squidgeefish/AxxSolder/AxxSolder_hardware/3rd-parties-libraries/3D-models/GMT020-02 Ver1.1 LCD.step

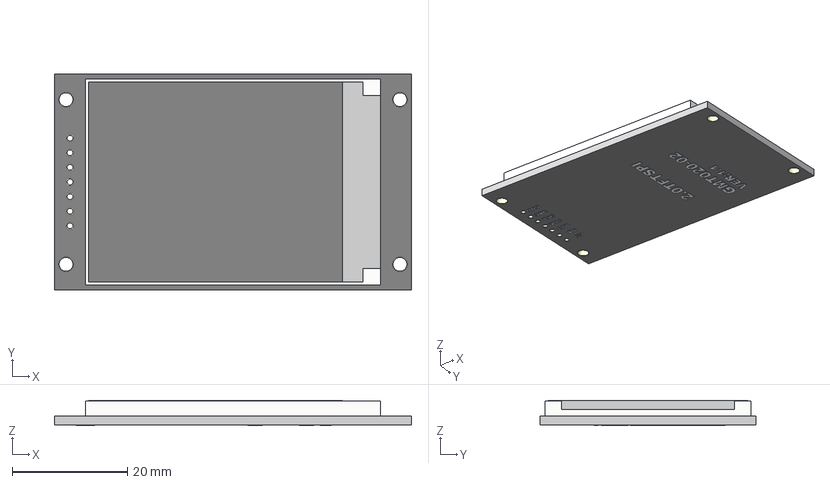
[picture p1: CAD file, 2024-05-25]
AxxSolder_hardware/3rd-parties-libraries/3D-models/GMT020-02 Ver1.1 LCD.step
62.0 x 37.5 x 4.40 mm
