squidgeefish/AxxSolder/AxxSolder_hardware/AxxSolder.kicad_pcb

## KiCad design AxxSolder_hardware/AxxSolder.kicad_pcb (2024-05-25)

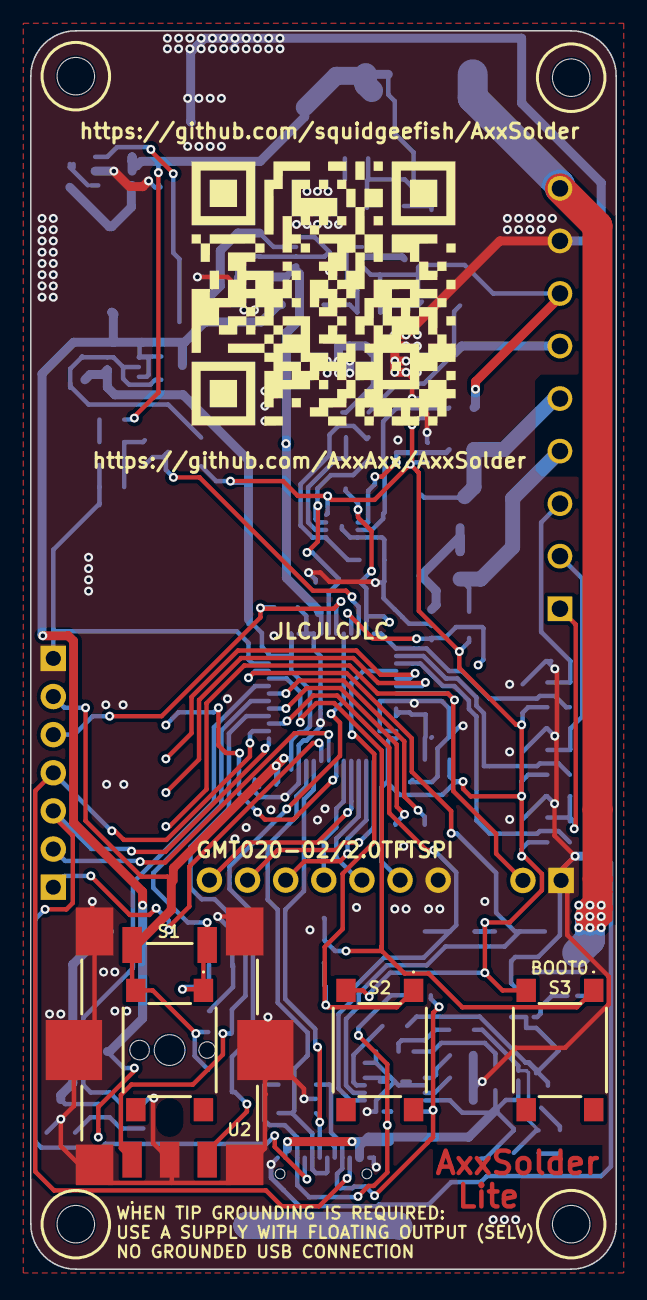
[picture p2: board AxxSolder.kicad_pcb from above]

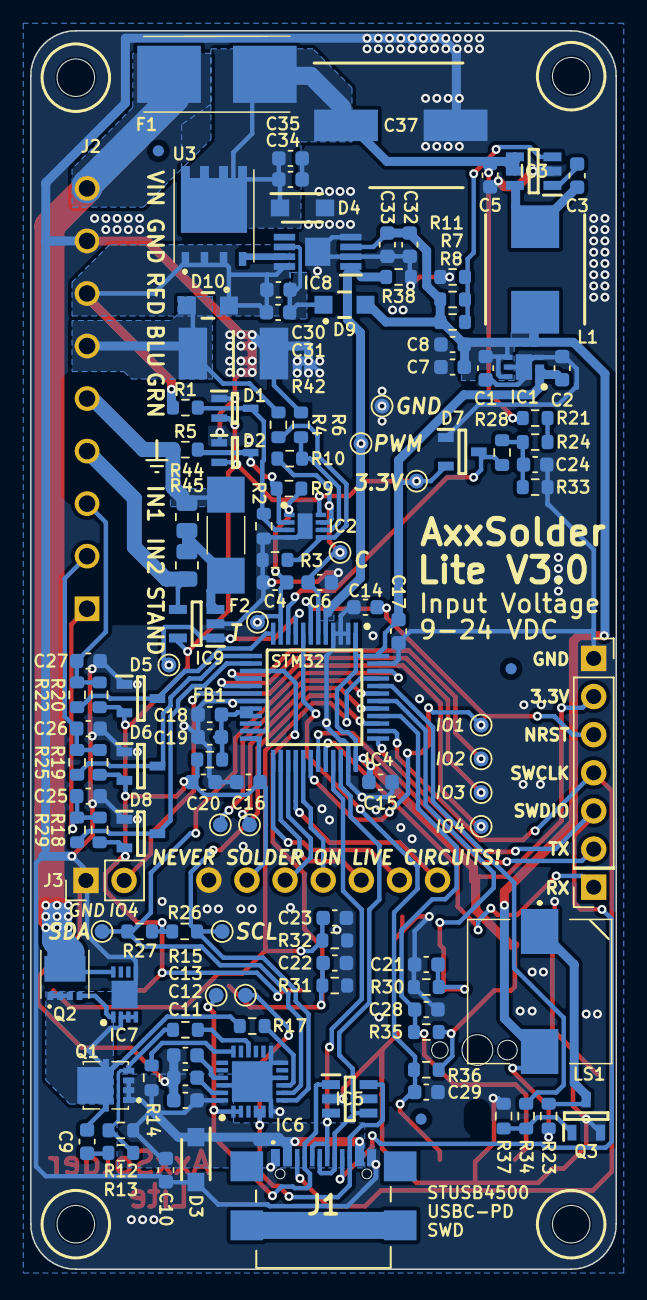
[picture p3: board AxxSolder.kicad_pcb from below]

Board: 2 copper layers, 39.0 x 82.5 mm, 137 parts (128 on the bottom side), 68 nets.

Parts:
C1, C2, C5, C7, C8, C10, C11, C12, C13, C19, C20, C30, C31, C32, C34, C35: 10u; C_0603_1608Metric
C3, C9, C14, C15, C16, C17, C18, C21, C22, C23, C24, C25, C26, C27, C28, C29, C33: 100n; C_0603_1608Metric
C4, C6: 1n; C_0603_1608Metric
C37: 220u; CAPAE830X1050N
D1, D2: BAV199WQ-7; SOT65P210X110-3N
D3, D4: SMF4L24AT1G; SODFL3619X98N
D5, D6, D7, D8: BAT54S; SOT95P230X110-3N
D9, D10: PMEG6020ER; PMEG6020ER115
F1: 0154007.DR; 0154100DR
F2: SF-2410FP100W-2; SF2410FP100W2
FB1: BLM18HE601SN1D; R_0603_1608Metric
FID1, FID2, FID3: Fiducial; Fiducial_0.75mm_Mask1.5mm
H1, H2, H3, H4: MountingHole; MountingHole_2.5mm
IC1: TLV76733DRVR; SON65P200X200X80-7N
IC2: OPA2387DSGT; SON50P200X200X80-9N
IC3: LMR54406DBVR; SOT95P280X145-6N
IC4: STM32G431CBT6; QFP50P900X900X160-48N
IC5: TPD4E1U06DBVR; SOT95P280X145-6N
IC6: STUSB4500QTR; QFN50P400X400X100-25N-D
IC7: MAX16171ATA_VY+T; SON50P300X200X80-9N
IC8: LTC4440AHMS8E; SOP65P490X110-9N
IC9: INA281A5QDBVRQ1; SOT95P280X145-5N
J1: USB4110-GF-A; USB4110GFA
J2: 691243110009
J3: TSW-102-07-T-S; PinHeader_1x02_P2.54mm_Vertical
J4: 61300611821; RHDR6W97P0X254_1X6_1574X250X865P
L1: SRP7028CC-150M; INDPM7366X300N
LS1: CMI-9653S-SMT-TR; CMI9653SSMTTR
Q1: STL9P3LLH6; STL20N6F7
Q2: STL10N3LLH5
Q3: 2N7002NXAKR; SOT95P230X110-3N
R1, R5, R14, R17: 1k5; R_0603_1608Metric
R2, R7, R8, R9: 360k; R_0603_1608Metric
R3, R10: 220k; R_0603_1608Metric
R4, R6, R18, R19, R20, R22, R23, R25, R26, R27, R28, R29, R30, R31, R32, R33, R35, R36, R37, R38: 4k7; R_0603_1608Metric
R11, R12, R15, R21, R24: 22k; R_0603_1608Metric
R13, R34: 100; R_0603_1608Metric
R42: 5m; RESC6432X89N
R44: 1M; R_0805_2012Metric
R45: 100m; R_0805_2012Metric
S1, S2, S3: ADTSM644RVTR
TP1, TP2, TP4, TP5, TP6, TP7, TP8, TP14, TP15, TP16: DIAG_TP; TestPoint_Pad_D1.0mm
TP3: 3.3V_TP; TestPoint_Pad_D1.0mm
TP9, TP10: Current_TP; TestPoint_Pad_D1.0mm
TP11: TC_TP; TestPoint_Pad_D1.0mm
TP12: GND_TP; TestPoint_Pad_D1.0mm
TP13: DIAG_TP; PinSocket_1x01_P2.54mm_Vertical
TP17: SW_TP; TestPoint_Pad_D1.0mm
U1: PinHeader_1x07_P2.54mm_Vertical
U2: PEC11J-9215F-S0015; PEC11J9215FS0015
U3: BSC014N04LS

Connections:
+3.3V: C2.1, C15.1, C16.1, C17.1, C20.2, D1.2, D2.2, D5.2 (K), D6.2 (K), D7.2 (K), D8.2 (K), FB1.2, IC1.1 (OUT), IC1.2 (SNS), IC2.8 (V+), IC4.1 (VBAT), IC4.24 (VDD_1), IC4.36 (VDD_2), IC4.48 (VDD_3), IC9.5 (VS), J4.2, R18.1, R19.1, R20.1, R26.2, R27.2, R35.2, R36.1, S1.2, S2.2, S3.2, TP3.1, U1.6 (3V3), U2.D1
+7.5V: C1.1, C7.2, C8.2, C32.1, C33.1, D9.2, IC1.4 (EN), IC1.6 (IN), IC8.3 (VCC), L1.2, LS1.2 (+), R7.2, R8.2, R23.1
/BLUE: D10.2, J2.6, R4.1, R42.1
/BOOST: C30.2, C31.2, D9.1, IC8.6 (BOOST)
/Buzzer: IC4.44 (PB7), R34.1
/CC1: IC5.1 (IO1), IC6.1 (CC1DB), IC6.2 (CC1), J1.A5 (CC1), TP7.1
/CC1_: IC4.43 (PB6), TP1.1
/CC2: IC5.6 (IO4), IC6.4 (CC2), IC6.5 (CC2DB), J1.B5 (CC2), TP8.1
/CC2_: IC4.41 (PB4), TP2.1
/CURRENT: C6.1, IC2.7, IC4.6 (PF1_-_OSC_OUT), R10.1, TP10.1
/ENC_A: C29.1, IC4.8 (PA0), R36.2, U2.C1
/ENC_B: C28.1, IC4.40 (PB3), R35.1, U2.A1
/GREEN: F2.2, J2.5, R5.1, R44.2
/H_sense1: C27.1, J2.3, R20.2, R22.2
/H_sense2: C26.1, J2.2, R19.2, R25.2
/Handle_inp1: D5.3 (common), IC4.12 (PA4), R22.1
/Handle_inp2: D6.3 (common), IC4.13 (PA5), R25.1
/Heater: IC4.5 (PF0_-_OSC_IN), IC8.1 (INP), R38.1, TP17.1
/I_LEAK: IC4.9 (PA1), IC9.1 (OUT), TP9.1
/NRST: C14.2, IC4.7 (PG10_-_NRST), J4.3
/RED: C30.1, C31.1, D10.1, IC8.8 (TS), J2.7, R1.1, U3.1 (S)
/SCL: IC4.39 (PA15), IC6.7 (SCL), R26.1, TP15.1
/SDA: IC4.46 (PB9), IC6.8 (SDA), R27.1, TP16.1
/SPI_CS: IC4.28 (PB14), U1.1 (CS)
/SPI_DC: IC4.25 (PB11), U1.2 (DC)
/SPI_MOSI: IC4.29 (PB15), U1.4 (MOSI)
/SPI_RST: IC4.26 (PB12), U1.3 (RST)
/SPI_SCK: IC4.27 (PB13), U1.5 (SCK)
/SW1: C21.1, IC4.42 (PB5), R30.1, S1.1, U2.E1
/SW2: C22.1, IC4.15 (PA7), R31.1, S2.1
/SW3: C23.1, IC4.45 (PB8-BOOT0), R32.1, S3.1
/SWCLK: IC4.38 (PA14), J1.B8 (SBU2), J4.4
/SWDIO: IC4.37 (PA13), J1.A8 (SBU1), J4.5
/S_sense: C25.1, J2.1, R18.2, R29.2
/Stand_inp: D8.3 (common), IC4.14 (PA6), R29.1
/TC: C4.1, IC2.1, IC4.11 (PA3), R9.1, TP11.1
/USART_RX: IC4.32 (PA10), TP13.1
/USART_TX: IC4.31 (PA9), J4.6
/USB_D+: IC4.34 (PA12), IC5.4 (IO3), J1.A6 (D+), J1.B6 (D+)
/USB_D-: IC4.33 (PA11), IC5.3 (IO2), J1.A7 (D-), J1.B7 (D-)
/USR1: IC4.30 (PA8), TP4.1
/USR2: IC4.16 (PB0), TP6.1
/USR3: IC4.17 (PB1), TP5.1
/USR4: IC4.18 (PB2), J3.2, TP14.1
/VBUS: C10.2, C11.1, D3.1 (K), IC6.24 (VDD), J1.A4 (VBUS), J1.A9 (VBUS), J1.B4 (VBUS), J1.B9 (VBUS), Q1.1 (S), R12.2, R14.2
/VBUS_IN: D7.3 (common), IC4.10 (PA2), R28.2
/VCCA: C18.1, C19.1, FB1.1, IC4.20 (VREF+), IC4.21 (VDDA)
/VDD_IN: F1.2, IC7.8 (OUT), J2.9, Q2.5 (D)
/VDD_IN_USBCPD: C9.2, IC7.2 (SRC), IC7.3 (IN), IC7.4 (EN), Q1.5 (D), Q2.1 (S), R17.2
Earth: IC9.4 (IN-), J2.4, R45.1
GND: C1.2, C2.2, C4.2, C5.1, C6.2, C7.1, C8.1, C10.1, C11.2, C12.2, C13.2, C14.1, C15.2, C16.2, C17.2, C18.2, C19.2, C20.1, C21.2, C22.2, C23.2, C24.2, C25.2, C26.2, C27.2, C28.2, C29.2, C32.2, C33.2, C34.1, C35.1, C37.2, D1.1, D2.1, D3.2 (A), D4.2 (A), D5.1 (A), D6.1 (A), D7.1 (A), D8.1 (A), IC1.3 (GND_1), IC1.5 (GND_2), IC1.7 (EP), IC2.4 (V-), IC2.9 (THERMAL_PAD), IC3.2 (GND), IC4.2 (PC13), IC4.3 (PC14_-_OSC32_IN), IC4.4 (PC15_-_OSC32_OUT), IC4.19 (VSSA), IC4.23 (VSS_1), IC4.35 (VSS_2), IC4.47 (VSS_3), IC5.2 (GND), IC6.6 (RESET), IC6.10 (GND), IC6.12 (ADDR0), IC6.13 (ADDR1), IC6.22 (VSYS), IC6.25 (EP), IC7.5 (GND), IC7.9 (EP), IC8.2 (GND_1), IC8.4 (GND_2), IC8.9 (EP), IC9.2 (GND), J1.A1 (GND), J1.A12 (GND), J1.B1 (GND), J1.B12 (GND), J2.8, J3.1, J4.1, Q3.2 (S), R2.2, R3.2, R6.2, R11.1, R30.2, R31.2, R32.2, R33.2, R37.2, R38.2, R42.2, TP12.1, U1.7 (GND), U2.B1, U2.MP
unnamed: C9.1, R13.2
unnamed: C24.1, R24.1, R28.1, R33.1
unnamed: D1.3, IC2.3 (+), R1.2, R2.1
unnamed: D2.3, IC2.2 (-), R5.2, R9.2
unnamed: IC2.5 (+), R3.1, R4.2
unnamed: IC2.6 (-), R6.1, R10.2
unnamed: C3.1, IC3.1 (CB)
unnamed: IC3.3 (FB), R7.1, R8.1, R11.2
unnamed: C3.2, IC3.6 (SW), L1.1
unnamed: IC7.1 (GATE), Q2.4 (G)
unnamed: IC8.7 (TG), U3.9 (G)
unnamed: F2.1, IC9.3 (IN+), R44.1, R45.2
unnamed: LS1.1 (-), Q3.3 (D), R23.2
unnamed: Q1.4 (G), R12.1, R13.1, R15.2
unnamed: Q3.1 (G), R34.2, R37.1
unnamed: R21.1, R24.2
VDD: C5.2, C34.2, C35.2, C37.1, D4.1 (K), F1.1, IC3.4 (EN), IC3.5 (VIN), R21.2, U3.10 (D)
