squidgeefish/AxxSolder/AxxSolder_firmware/Core/Src/main.c

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
/* Includes ------------------------------------------------------------------*/
#include "main.h"

/* USER CODE BEGIN Includes */
#include "lcd.h"
#include "string.h"
#include "pid.h"
#include "moving_average.h"
#include "flash.h"
#include "stusb4500.h"
#include <math.h>
#include <stdio.h>
//#include "usbd_cdc_if.h"
/* USER CODE END Includes */

/* USER CODE BEGIN PTD */
#define version "3.0.2"

enum handles {
	NT115,
	T210,
	T245
} handle;

/* Timing constants */
uint32_t previous_millis_display = 0;
uint32_t interval_display = 40;

uint32_t previous_millis_debug = 0;
uint32_t interval_debug = 50;

uint32_t previous_PID_update = 0;
uint32_t interval_PID_update = 25;

uint32_t previous_millis_HANDLE_update = 0;
uint32_t interval_HANDLE_update = 200;

uint32_t previous_millis_heating_halted_update = 0;
uint32_t interval_heating_halted_update = 500;

uint32_t previous_millis_left_stand = 0;

uint32_t previous_standby_millis = 0;

uint32_t previous_measure_current_update = 0;
uint32_t interval_measure_current = 250;

uint32_t previous_sensor_update_high_update = 0;
uint32_t interval_sensor_update_high_update = 10;

uint32_t previous_sensor_update_low_update = 0;
uint32_t interval_sensor_update_low_update = 100;

/* Button flags */
uint8_t SW_ready = 1;
uint8_t SW_1_pressed = 0;
uint8_t SW_2_pressed = 0;
uint8_t SW_3_pressed = 0;

/* states for runtime switch */
typedef enum {
    RUN,
	STANDBY,
	SLEEP,
	EMERGENCY_SLEEP,
	HALTED,
} mainstates;
mainstates active_state = SLEEP;

uint8_t sleep_state_written_to_LCD = 0;
uint8_t standby_state_written_to_LCD = 0;

/* Custom tuning parameters */
double Kp_tuning = 0;
double Ki_tuning = 0;
double Kd_tuning = 0;
double temperature_tuning = 100;
double PID_MAX_I_LIMIT_tuning = 0;

/* PID tuning parameters */
double Kp = 0;
double Ki = 0;
double Kd = 0;
double PID_MAX_I_LIMIT = 150;

/* PID parameters */
#define PID_MAX_OUTPUT 500

/* Function to detect tip presence by a periodic voltage and measure the current */
#define DETECT_TIP_BY_CURRENT

/* Buffer for UART print */
char buffer[40];

/* Converts power in W to correct duty cycle */
#define POWER_REDUCTION_FACTOR 0.123

/* Filtered ADC reading value */
float ADC_filter_mean = 0.0;

/* ADC Buffer */
#define ADC1_BUF_LEN 57 //3*19
uint16_t ADC1_BUF[ADC1_BUF_LEN];

/* RAW ADC data */
uint16_t mcu_temperature_raw = 0;
uint16_t current_raw = 0;

double TC_temp = 0;

/* Max allowed tip temperature */
#define EMERGENCY_SHUTDOWN_TEMPERATURE 490

/* Constants for scaling input voltage ADC value*/
#define VOLTAGE_COMPENSATION 0.00840442388
#define CURRENT_COMPENSATION 0.002864

/* Min allowed bus voltage */
#define MIN_BUSVOLTAGE 8.0

/* MinMax selectable values */
double min_selectable_temperature = 20;
double max_selectable_temperature = 450;

/* Allow use of custom temperatue, used for tuning */
uint8_t custom_temperature_on = 0;

/* TC Compensation constants */
#define TC_COMPENSATION_X2_NT115 5.1026665462522864e-05
#define TC_COMPENSATION_X1_NT115 0.42050803230712813
#define TC_COMPENSATION_X0_NT115 20.14538589052425

#define TC_COMPENSATION_X2_T210 4.223931712905644e-06
#define TC_COMPENSATION_X1_T210 0.31863796444354214
#define TC_COMPENSATION_X0_T210 20.968033870812942

#define TC_COMPENSATION_X2_T245 (-4.735112838956741e-07)
#define TC_COMPENSATION_X1_T245 0.11936452029674384
#define TC_COMPENSATION_X0_T245 23.777399955382318

/* Constants for internal MCU temperture */
#define V30 0.76 			// from datasheet
#define VSENSE (3.3/4096.0) 	// VSENSE value
#define Avg_Slope 0.0025 	// 2.5mV from datasheet


/* Struct to hold sensor values */
struct sensor_values_struct {
	double set_temperature;
	double thermocouple_temperature;
	double thermocouple_temperature_display;
	float bus_voltage;
	float heater_current;
	uint16_t leak_current;
	float mcu_temperature;
	double in_stand;
	double handle1_sense;
	double handle2_sense;
	mainstates previous_state;
	double enc_button_status;
	float max_power_watt;
};

struct sensor_values_struct sensor_values  = {.set_temperature = 0.0,
        									.thermocouple_temperature = 0.0,
											.thermocouple_temperature_display = 0,
											.bus_voltage = 0.0,
											.heater_current = 0,
											.leak_current = 0,
											.mcu_temperature = 0.0,
											.in_stand = 0.0,
											.handle1_sense  = 0.0,
											.handle2_sense  = 0.0,
											.previous_state = SLEEP,
											.enc_button_status = 0.0,
											.max_power_watt = 0};

/* Struct to hold flash values */
Flash_values flash_values;
Flash_values default_flash_values = {.startup_temperature = 330,
											.temperature_offset = 0,
											.standby_temp = 150,
											.standby_time = 10,
											.emergency_time = 30,
											.buzzer_enable = 1,
											.preset_temp_1 = 330,
											.preset_temp_2 = 430,
											.GPIO4_ON_at_run = 0,
											.screen_rotation = 0,
											.power_limit = 0,
											.current_measurement = 1};

/* List of names for settings menue */
#define menu_length 15
char menu_names[menu_length][22] = { "Startup Temp  ",
							"Temp Offset    ",
							"Standby Temp   ",
							"Standby Time   ",
							"Sleep Time       ",
							"Buzzer Enable      ",
							"Preset Temp 1      ",
							"Preset Temp 2      ",
							"GPIO4 ON at run    ",
							"Screen rotation      ",
							"Limit Power        ",
							"I measurement       ",
							"-Load Default-       ",
							"-Save and Reboot- ",
							"-Exit no Save-        "};


/* PID data */
double PID_output = 0.0;
double PID_setpoint = 0.0;
double duty_cycle = 0.0;

/* Flags for temp asn current measurements */
uint8_t current_measurement_requested = 0;
uint8_t current_measurement_done = 1;
uint8_t thermocouple_measurement_requested = 0;
uint8_t thermocouple_measurement_done = 1;

/* Moving average filters for sensor data */
FilterTypeDef thermocouple_temperature_filter_struct;
FilterTypeDef thermocouple_temperature_display_filter_struct;
FilterTypeDef mcu_temperature_filter_struct;
FilterTypeDef input_voltage_filterStruct;
FilterTypeDef current_filterStruct;
FilterTypeDef stand_sense_filterStruct;
FilterTypeDef handle1_sense_filterStruct;
FilterTypeDef handle2_sense_filterStruct;

/* USER CODE END PTD */

ADC_HandleTypeDef hadc1;
ADC_HandleTypeDef hadc2;
DMA_HandleTypeDef hdma_adc1;

CRC_HandleTypeDef hcrc;

I2C_HandleTypeDef hi2c1;

SPI_HandleTypeDef hspi2;
DMA_HandleTypeDef hdma_spi2_tx;

TIM_HandleTypeDef htim1;
TIM_HandleTypeDef htim2;
TIM_HandleTypeDef htim4;
TIM_HandleTypeDef htim6;
TIM_HandleTypeDef htim7;
TIM_HandleTypeDef htim8;
TIM_HandleTypeDef htim16;
TIM_HandleTypeDef htim17;

UART_HandleTypeDef huart1;

void SystemClock_Config(void);
static void MX_GPIO_Init(void);
static void MX_DMA_Init(void);
static void MX_ADC1_Init(void);
static void MX_ADC2_Init(void);
static void MX_CRC_Init(void);
static void MX_TIM1_Init(void);
static void MX_TIM2_Init(void);
static void MX_TIM4_Init(void);
static void MX_SPI2_Init(void);
static void MX_I2C1_Init(void);
static void MX_TIM17_Init(void);
static void MX_USART1_UART_Init(void);
static void MX_TIM7_Init(void);
static void MX_TIM8_Init(void);
static void MX_TIM6_Init(void);
static void MX_TIM16_Init(void);
/* USER CODE BEGIN 0 */
PID_TypeDef TPID;

/* Function to clamp d between the limits min and max */
double clamp(double d, double min, double max) {
  const double t = d < min ? min : d;
  return t > max ? max : t;
}

/* Returns the average of 100 readings of the index+3*n value in the ADC_buffer vector */
double get_mean_ADC_reading_indexed(uint8_t index){
	ADC_filter_mean = 0;
	for(int n=index;n<ADC1_BUF_LEN;n=n+3){
		ADC_filter_mean += ADC1_BUF[n];
	}
	return ADC_filter_mean/(ADC1_BUF_LEN/3.0);
}

void get_mcu_temp(){
	sensor_values.mcu_temperature =	Moving_Average_Compute((((get_mean_ADC_reading_indexed(2) * VSENSE) - V30) / Avg_Slope + 25), &mcu_temperature_filter_struct);
}

uint16_t RGB_to_BRG(uint16_t color){
	//return ((color & 0b0000000000011111)  << 11)    |    ((color & 0b1111100000000000) >> 5)   |    ((color  & 0b0000011111100000) >> 6);
	return ((((color & 0b0000000000011111)  << 11) & 0b1111100000000000) | ((color & 0b1111111111100000) >> 5));
}

void change_state(mainstates new_state){
	sensor_values.previous_state = active_state;
	active_state = new_state;
	if((active_state == RUN) && (flash_values.GPIO4_ON_at_run == 1)){
		HAL_GPIO_WritePin(GPIOB, USR_4_Pin, GPIO_PIN_SET);
	}
	else{
		HAL_GPIO_WritePin(GPIOB, USR_4_Pin, GPIO_PIN_RESET);
	}
}

void get_bus_voltage(){
	sensor_values.bus_voltage = Moving_Average_Compute(get_mean_ADC_reading_indexed(0), &input_voltage_filterStruct)*VOLTAGE_COMPENSATION;
}

void get_heater_current(){
	sensor_values.heater_current = Moving_Average_Compute(current_raw, &current_filterStruct)*CURRENT_COMPENSATION;
}

void get_thermocouple_temperature(){
	TC_temp = Moving_Average_Compute(get_mean_ADC_reading_indexed(1), &thermocouple_temperature_filter_struct); /* Moving average filter */

	if(handle == T210){
		sensor_values.thermocouple_temperature = TC_temp*TC_temp*TC_COMPENSATION_X2_T210 + TC_temp*TC_COMPENSATION_X1_T210 + TC_COMPENSATION_X0_T210;
	}
	else if(handle == T245){
		sensor_values.thermocouple_temperature = TC_temp*TC_temp*TC_COMPENSATION_X2_T245 + TC_temp*TC_COMPENSATION_X1_T245 + TC_COMPENSATION_X0_T245;
	}
	else if(handle == NT115){
		sensor_values.thermocouple_temperature = TC_temp*TC_temp*TC_COMPENSATION_X2_NT115 + TC_temp*TC_COMPENSATION_X1_NT115 + TC_COMPENSATION_X0_NT115;
	}
	sensor_values.thermocouple_temperature += flash_values.temperature_offset; // Add temperature offset value
	sensor_values.thermocouple_temperature = clamp(sensor_values.thermocouple_temperature ,0 ,999); // Clamp

	sensor_values.thermocouple_temperature_display = Moving_Average_Compute(sensor_values.thermocouple_temperature, &thermocouple_temperature_display_filter_struct); /* Moving average filter */
}

/* Sets the duty cycle of timer controlling the heater */
void set_heater_duty(uint16_t dutycycle){
	__HAL_TIM_SET_COMPARE(&htim1, TIM_CHANNEL_3, dutycycle);
	__HAL_TIM_SET_COMPARE(&htim1, TIM_CHANNEL_1, dutycycle*0.3);
}

/* Update the duty cycle of timer controlling the heater PWM */
void heater_on(){
	duty_cycle = PID_output*(sensor_values.max_power_watt*POWER_REDUCTION_FACTOR/sensor_values.bus_voltage);
	set_heater_duty(clamp(duty_cycle, 0.0, PID_MAX_OUTPUT));
}

/* Disable the duty cycle of timer controlling the heater PWM*/
void heater_off(){
	set_heater_duty(0);
}

void settings_menue(){
	/* If SW_1 is pressed during startup - Show SETTINGS and allow to release button. */
	if (HAL_GPIO_ReadPin (GPIOB, SW_1_Pin) == 1){
		if((flash_values.screen_rotation == 0) || (flash_values.screen_rotation == 2)){
			LCD_PutStr(6, 300, "Version:", FONT_arial_20X23, RGB_to_BRG(C_RED), RGB_to_BRG(C_BLACK));
			LCD_PutStr(150, 300, version, FONT_arial_20X23, RGB_to_BRG(C_RED), RGB_to_BRG(C_BLACK));
		}
		else{
			LCD_PutStr(0, 215, "Version:", FONT_arial_20X23, RGB_to_BRG(C_RED), RGB_to_BRG(C_BLACK));
			LCD_PutStr(150, 215, version, FONT_arial_20X23, RGB_to_BRG(C_RED), RGB_to_BRG(C_BLACK));
		}

		TIM2->CNT = 1000;
		uint16_t menu_cursor_position = 0;
		uint16_t old_menu_cursor_position = 0;
		uint16_t menue_start = 0;
		uint16_t menue_level = 0;
		uint16_t menu_active = 1;
		float old_value = 0;

		LCD_PutStr(60, 12, "SETTINGS", FONT_arial_20X23, RGB_to_BRG(C_YELLOW), RGB_to_BRG(C_BLACK));
		LCD_DrawLine(0,40,240,40,RGB_to_BRG(C_YELLOW));
		LCD_DrawLine(0,41,240,41,RGB_to_BRG(C_YELLOW));
		LCD_DrawLine(0,42,240,42,RGB_to_BRG(C_YELLOW));

		HAL_Delay(500);
		while(menu_active == 1){
			if(menue_level == 0){
				TIM2->CNT = clamp(TIM2->CNT, 1000, 1000000);
				menu_cursor_position = (TIM2->CNT - 1000) / 2;
			}
			if (menue_level == 1){
				if (menu_cursor_position == 10){
					((double*)&flash_values)[menu_cursor_position] = (float)old_value + round(((float)(TIM2->CNT - 1000.0) / 2.0 - (float)menu_cursor_position)) * 5;
				}
				else{
					((double*)&flash_values)[menu_cursor_position] = (float)old_value + (float)(TIM2->CNT - 1000.0) / 2.0 - (float)menu_cursor_position;
				}
				if ((menu_cursor_position == 5) || (menu_cursor_position == 8) || (menu_cursor_position == 11)){
					((double*)&flash_values)[menu_cursor_position] = fmod(round(fmod(fabs(((double*)&flash_values)[menu_cursor_position]), 2)), 2);
				}
				if (menu_cursor_position == 9){
					((double*)&flash_values)[menu_cursor_position] = fmod(round(fmod(fabs(((double*)&flash_values)[menu_cursor_position]), 4)), 4);
				}
				if(menu_cursor_position != 1){
					((double*)&flash_values)[menu_cursor_position] = fabs(((double*)&flash_values)[menu_cursor_position]);
				}
			}

			if(menu_cursor_position > menu_length-1){
							menu_cursor_position = menu_length-1;
							TIM2->CNT = 1000 + (menu_length-1)*2;
			}

			if(menu_cursor_position >= 6){
				menue_start = menu_cursor_position-6;
			}
			else{
				menue_start = 0;
			}

			if((HAL_GPIO_ReadPin (GPIOB, SW_1_Pin) == 1) && (menu_cursor_position < menu_length-3)){
				if(menue_level == 0){
					old_value = ((double*)&flash_values)[menu_cursor_position];
					old_menu_cursor_position = menu_cursor_position;
				}
				if(menue_level == 1){
					TIM2->CNT = old_menu_cursor_position*2 + 1000;
				}

				menue_level = abs(menue_level-1);
				HAL_Delay(200);
			}
			else if((HAL_GPIO_ReadPin (GPIOB, SW_1_Pin) == 1) && (menu_cursor_position == menu_length-1)){
				menu_active = 0;
			}
			else if((HAL_GPIO_ReadPin (GPIOB, SW_1_Pin) == 1) && (menu_cursor_position == menu_length-2)){
				menu_active = 0;
				FlashWrite(&flash_values);
				HAL_NVIC_SystemReset();
			}
			else if((HAL_GPIO_ReadPin (GPIOB, SW_1_Pin) == 1) && (menu_cursor_position == menu_length-3)){
				flash_values = default_flash_values;
			}

			for(int i = menue_start;i<=menue_start+6;i++){

				if((i == menu_cursor_position) && (menue_level == 0)){
					LCD_PutStr(5, 45+(i-menue_start)*25, menu_names[i], FONT_arial_20X23, RGB_to_BRG(C_BLACK), RGB_to_BRG(C_WHITE));
				}
				else{
					LCD_PutStr(5, 45+(i-menue_start)*25, menu_names[i], FONT_arial_20X23, RGB_to_BRG(C_WHITE), RGB_to_BRG(C_BLACK));
				}

				char str[20];
				memset(&str, '\0', sizeof(str));
				sprintf(str, "%.0f", (((double*)&flash_values)[i]));

				if((((double*)&flash_values)[i]) < -9.5){
					str[3] = 32;
				}

				else if((((double*)&flash_values)[i]) < 0){
					str[2] = 32;
					str[3] = 32;
					str[4] = 32;
				}

				else if((((double*)&flash_values)[i]) < 9.5){
					str[1] = 32;
					str[2] = 32;
					str[3] = 32;
					str[4] = 32;
				}
				else if((((double*)&flash_values)[i]) < 99.5){
					str[2] = 32;
					str[3] = 32;
				}

				if(i < menu_length-3){
					if((i == menu_cursor_position) && (menue_level == 1)){
						LCD_PutStr(200, 45+(i-menue_start)*25, str, FONT_arial_20X23, RGB_to_BRG(C_BLACK), RGB_to_BRG(C_WHITE));
					}
					else{
						LCD_PutStr(200, 45+(i-menue_start)*25, str, FONT_arial_20X23, RGB_to_BRG(C_WHITE), RGB_to_BRG(C_BLACK));
					}
				}
				if(i >= menu_length-3){
					LCD_PutStr(200, 45+(i-menue_start)*25, "        ", FONT_arial_20X23, RGB_to_BRG(C_WHITE), RGB_to_BRG(C_BLACK));
				}

			}
		}
	}
}

void update_display(){
	if((flash_values.screen_rotation == 0) || (flash_values.screen_rotation == 2)){
		memset(&buffer, '\0', sizeof(buffer));
		sprintf(buffer, "%.f", sensor_values.set_temperature);
		if(sensor_values.set_temperature < 99.5){
			buffer[2] = 32;
			buffer[3] = 32;
		}
		LCD_PutStr(14, 75, buffer, FONT_arial_36X44_NUMBERS, RGB_to_BRG(C_WHITE), RGB_to_BRG(C_BLACK));

		if((sensor_values.heater_current < 1) || (TC_temp > 4096-10)) { //NT115 at 9V draws 2.3
			LCD_PutStr(10, 165, " ---  ", FONT_arial_36X44_NUMBERS, RGB_to_BRG(C_WHITE), RGB_to_BRG(C_BLACK));
		}
		else{
			memset(&buffer, '\0', sizeof(buffer));
			sprintf(buffer, "%.f", sensor_values.thermocouple_temperature_display);
			if(sensor_values.thermocouple_temperature_display < 99.5){
				buffer[2] = 32;
				buffer[3] = 32;
			}
			LCD_PutStr(14, 165, buffer, FONT_arial_36X44_NUMBERS, RGB_to_BRG(C_WHITE), RGB_to_BRG(C_BLACK));
		}

		memset(&buffer, '\0', sizeof(buffer));
		sprintf(buffer, "%.1f", sensor_values.bus_voltage);
		LCD_PutStr(100, 255, buffer, FONT_arial_16X18, RGB_to_BRG(C_WHITE), RGB_to_BRG(C_BLACK));

		memset(&buffer, '\0', sizeof(buffer));
		sprintf(buffer, "%.1f", sensor_values.mcu_temperature);
		LCD_PutStr(100, 275, buffer, FONT_arial_16X18, RGB_to_BRG(C_WHITE), RGB_to_BRG(C_BLACK));

		if(handle == T210){
			LCD_PutStr(100, 235, "T210   ", FONT_arial_16X18, RGB_to_BRG(C_WHITE), RGB_to_BRG(C_BLACK));
		}
		else if(handle == T245){
			LCD_PutStr(100, 235, "T245   ", FONT_arial_16X18, RGB_to_BRG(C_WHITE), RGB_to_BRG(C_BLACK));
		}
		else if(handle == NT115){
			LCD_PutStr(100, 235, "NT115", FONT_arial_16X18, RGB_to_BRG(C_WHITE), RGB_to_BRG(C_BLACK));
		}

		if((active_state == SLEEP || active_state == EMERGENCY_SLEEP || active_state == HALTED) && !sleep_state_written_to_LCD){
			UG_FillFrame(210,55,230,286, RGB_to_BRG(C_ORANGE));
			LCD_PutStr(214, 58,  "Z", FONT_arial_20X23, RGB_to_BRG(C_BLACK), RGB_to_BRG(C_ORANGE));
			LCD_PutStr(216, 92, "z", FONT_arial_20X23, RGB_to_BRG(C_BLACK), RGB_to_BRG(C_ORANGE));
			LCD_PutStr(214, 126, "Z", FONT_arial_20X23, RGB_to_BRG(C_BLACK), RGB_to_BRG(C_ORANGE));
			LCD_PutStr(216, 161, "z", FONT_arial_20X23, RGB_to_BRG(C_BLACK), RGB_to_BRG(C_ORANGE));
			LCD_PutStr(214, 194, "Z", FONT_arial_20X23, RGB_to_BRG(C_BLACK), RGB_to_BRG(C_ORANGE));
			LCD_PutStr(216, 228, "z", FONT_arial_20X23, RGB_to_BRG(C_BLACK), RGB_to_BRG(C_ORANGE));
			LCD_PutStr(214, 262, "Z", FONT_arial_20X23, RGB_to_BRG(C_BLACK), RGB_to_BRG(C_ORANGE));
			sleep_state_written_to_LCD = 1;
			standby_state_written_to_LCD = 0;
		}
		else if((active_state == STANDBY) && !standby_state_written_to_LCD){
			UG_FillFrame(210, 55, 230,286, RGB_to_BRG(C_ORANGE));
			LCD_PutStr(214, 58,  "S", FONT_arial_20X23, RGB_to_BRG(C_BLACK), RGB_to_BRG(C_ORANGE));
			LCD_PutStr(214, 92,  "T", FONT_arial_20X23, RGB_to_BRG(C_BLACK), RGB_to_BRG(C_ORANGE));
			LCD_PutStr(214, 126, "A", FONT_arial_20X23, RGB_to_BRG(C_BLACK), RGB_to_BRG(C_ORANGE));
			LCD_PutStr(214, 161, "N", FONT_arial_20X23, RGB_to_BRG(C_BLACK), RGB_to_BRG(C_ORANGE));
			LCD_PutStr(214, 194, "D", FONT_arial_20X23, RGB_to_BRG(C_BLACK), RGB_to_BRG(C_ORANGE));
			LCD_PutStr(214, 228, "B", FONT_arial_20X23, RGB_to_BRG(C_BLACK), RGB_to_BRG(C_ORANGE));
			LCD_PutStr(214, 262, "Y", FONT_arial_20X23, RGB_to_BRG(C_BLACK), RGB_to_BRG(C_ORANGE));
			standby_state_written_to_LCD = 1;
			sleep_state_written_to_LCD = 0;
		}
		else if(active_state == RUN){
			UG_FillFrame(210, 287-(PID_output/PID_MAX_OUTPUT)*232, 	230, 	287, 									RGB_to_BRG(C_LIGHT_SKY_BLUE));
			UG_FillFrame(210, 55, 									230, 	287-(PID_output/PID_MAX_OUTPUT)*231-1, RGB_to_BRG(C_BLACK));
			standby_state_written_to_LCD = 0;
			sleep_state_written_to_LCD = 0;
		}
	}
	else{
		memset(&buffer, '\0', sizeof(buffer));
		sprintf(buffer, "%.f", sensor_values.set_temperature);
		if(sensor_values.set_temperature < 99.5){
			buffer[2] = 32;
			buffer[3] = 32;
		}
		LCD_PutStr(14, 30, buffer, FONT_arial_36X44_NUMBERS, RGB_to_BRG(C_WHITE), RGB_to_BRG(C_BLACK));

		if((sensor_values.heater_current < 1) || (TC_temp > 4096-10)) { //NT115 at 9V draws 2.3
			LCD_PutStr(10, 120, " ---  ", FONT_arial_36X44_NUMBERS, RGB_to_BRG(C_WHITE), RGB_to_BRG(C_BLACK));
		}
		else{
			memset(&buffer, '\0', sizeof(buffer));
			sprintf(buffer, "%.f", sensor_values.thermocouple_temperature);
			if(sensor_values.thermocouple_temperature < 99.5){
				buffer[2] = 32;
				buffer[3] = 32;
			}
			LCD_PutStr(14, 120, buffer, FONT_arial_36X44_NUMBERS, RGB_to_BRG(C_WHITE), RGB_to_BRG(C_BLACK));
		}

		memset(&buffer, '\0', sizeof(buffer));
		sprintf(buffer, "%.1f", sensor_values.bus_voltage);
		LCD_PutStr(100, 195, buffer, FONT_arial_16X18, RGB_to_BRG(C_WHITE), RGB_to_BRG(C_BLACK));

		memset(&buffer, '\0', sizeof(buffer));
		sprintf(buffer, "%.1f", sensor_values.mcu_temperature);
		LCD_PutStr(100, 210, buffer, FONT_arial_16X18, RGB_to_BRG(C_WHITE), RGB_to_BRG(C_BLACK));

		if(handle == T210){
			LCD_PutStr(100, 180, "T210   ", FONT_arial_16X18, RGB_to_BRG(C_WHITE), RGB_to_BRG(C_BLACK));
		}
		else if(handle == T245){
			LCD_PutStr(100, 180, "T245   ", FONT_arial_16X18, RGB_to_BRG(C_WHITE), RGB_to_BRG(C_BLACK));
		}
		else if(handle == NT115){
			LCD_PutStr(100, 180, "NT115", FONT_arial_16X18, RGB_to_BRG(C_WHITE), RGB_to_BRG(C_BLACK));
		}

		if((active_state == SLEEP || active_state == EMERGENCY_SLEEP || active_state == HALTED) && !sleep_state_written_to_LCD){
			UG_FillFrame(290,5,310,226, RGB_to_BRG(C_ORANGE));

			LCD_PutStr(294, 3,  "Z", FONT_arial_20X23, RGB_to_BRG(C_BLACK), RGB_to_BRG(C_ORANGE));
			LCD_PutStr(296, 38, "z", FONT_arial_20X23, RGB_to_BRG(C_BLACK), RGB_to_BRG(C_ORANGE));
			LCD_PutStr(294, 73, "Z", FONT_arial_20X23, RGB_to_BRG(C_BLACK), RGB_to_BRG(C_ORANGE));
			LCD_PutStr(296, 108, "z", FONT_arial_20X23, RGB_to_BRG(C_BLACK), RGB_to_BRG(C_ORANGE));
			LCD_PutStr(294, 143, "Z", FONT_arial_20X23, RGB_to_BRG(C_BLACK), RGB_to_BRG(C_ORANGE));
			LCD_PutStr(296, 178, "z", FONT_arial_20X23, RGB_to_BRG(C_BLACK), RGB_to_BRG(C_ORANGE));
			sleep_state_written_to_LCD = 1;
			standby_state_written_to_LCD = 0;
		}
		else if((active_state == STANDBY) && !standby_state_written_to_LCD){
			UG_FillFrame(290,5,310,226, RGB_to_BRG(C_ORANGE));
			LCD_PutStr(294, 3,  "S", FONT_arial_20X23, RGB_to_BRG(C_BLACK), RGB_to_BRG(C_ORANGE));
			LCD_PutStr(294, 32,  "T", FONT_arial_20X23, RGB_to_BRG(C_BLACK), RGB_to_BRG(C_ORANGE));
			LCD_PutStr(294, 61, "A", FONT_arial_20X23, RGB_to_BRG(C_BLACK), RGB_to_BRG(C_ORANGE));
			LCD_PutStr(294, 90, "N", FONT_arial_20X23, RGB_to_BRG(C_BLACK), RGB_to_BRG(C_ORANGE));
			LCD_PutStr(294, 119, "D", FONT_arial_20X23, RGB_to_BRG(C_BLACK), RGB_to_BRG(C_ORANGE));
			LCD_PutStr(294, 148, "B", FONT_arial_20X23, RGB_to_BRG(C_BLACK), RGB_to_BRG(C_ORANGE));
			LCD_PutStr(294, 177, "Y", FONT_arial_20X23, RGB_to_BRG(C_BLACK), RGB_to_BRG(C_ORANGE));
			standby_state_written_to_LCD = 1;
			sleep_state_written_to_LCD = 0;
		}
		else if(active_state == RUN){
			UG_FillFrame(290, 226-(PID_output/PID_MAX_OUTPUT)*221, 	310, 	226, 									RGB_to_BRG(C_LIGHT_SKY_BLUE));
			UG_FillFrame(290, 5, 									310, 	226-(PID_output/PID_MAX_OUTPUT)*211-1, RGB_to_BRG(C_BLACK));
			standby_state_written_to_LCD = 0;
			sleep_state_written_to_LCD = 0;
		}
	}
}

void LCD_draw_main_screen(){
	if((flash_values.screen_rotation == 0) || (flash_values.screen_rotation == 2)){
		UG_FillScreen(RGB_to_BRG(C_BLACK));

		LCD_PutStr(53, 12, "AxxSolder", FONT_arial_19X22, RGB_to_BRG(C_YELLOW), RGB_to_BRG(C_BLACK));
		LCD_DrawLine(0,40,240,40,RGB_to_BRG(C_YELLOW));
		LCD_DrawLine(0,41,240,41,RGB_to_BRG(C_YELLOW));
		LCD_DrawLine(0,42,240,42,RGB_to_BRG(C_YELLOW));


		LCD_PutStr(14, 50, "Set temp", FONT_arial_20X23, RGB_to_BRG(C_WHITE), RGB_to_BRG(C_BLACK));
		UG_DrawCircle(120, 85, 5, RGB_to_BRG(C_WHITE));
		UG_DrawCircle(120, 85, 4, RGB_to_BRG(C_WHITE));
		UG_DrawCircle(120, 85, 3, RGB_to_BRG(C_WHITE));
		LCD_PutStr(130, 75, "C", FONT_arial_36X44_C, RGB_to_BRG(C_WHITE), RGB_to_BRG(C_BLACK));


		LCD_PutStr(14, 140, "Actual temp", FONT_arial_20X23, RGB_to_BRG(C_WHITE), RGB_to_BRG(C_BLACK));
		UG_DrawCircle(120, 175, 5, RGB_to_BRG(C_WHITE));
		UG_DrawCircle(120, 175, 4, RGB_to_BRG(C_WHITE));
		UG_DrawCircle(120, 175, 3, RGB_to_BRG(C_WHITE));
		LCD_PutStr(130, 165, "C", FONT_arial_36X44_C, RGB_to_BRG(C_WHITE), RGB_to_BRG(C_BLACK));

		UG_DrawFrame(6, 134, 182, 220, RGB_to_BRG(C_WHITE));
		UG_DrawFrame(5, 133, 183, 221, RGB_to_BRG(C_WHITE));

		LCD_PutStr(6, 235, "Handle type:", FONT_arial_16X18, RGB_to_BRG(C_WHITE), RGB_to_BRG(C_BLACK));
		LCD_PutStr(6, 255, "Input voltage:           V", FONT_arial_16X18, RGB_to_BRG(C_WHITE), RGB_to_BRG(C_BLACK));
		LCD_PutStr(6, 275, "MCU temp:              deg C", FONT_arial_16X18, RGB_to_BRG(C_WHITE), RGB_to_BRG(C_BLACK));

		UG_DrawLine(2, 296, 240, 296, RGB_to_BRG(C_DARK_SEA_GREEN));
		UG_DrawLine(2, 297, 240, 297, RGB_to_BRG(C_DARK_SEA_GREEN));


		LCD_PutStr(6, 301, "PRESETS", FONT_arial_20X23, RGB_to_BRG(C_DARK_SEA_GREEN), RGB_to_BRG(C_BLACK));
		memset(&buffer, '\0', sizeof(buffer));
		sprintf(buffer, "%.0f", flash_values.preset_temp_1);
		LCD_PutStr(130, 301, buffer, FONT_arial_20X23, RGB_to_BRG(C_DARK_SEA_GREEN), RGB_to_BRG(C_BLACK));
		memset(&buffer, '\0', sizeof(buffer));
		sprintf(buffer, "%.0f", flash_values.preset_temp_2);
		LCD_PutStr(190, 301, buffer, FONT_arial_20X23, RGB_to_BRG(C_DARK_SEA_GREEN), RGB_to_BRG(C_BLACK));

		UG_DrawFrame(208, 53, 232, 289, RGB_to_BRG(C_WHITE));
		UG_DrawFrame(209, 54, 231, 288, RGB_to_BRG(C_WHITE));
	}
	else{
		UG_FillScreen(RGB_to_BRG(C_BLACK));

		LCD_PutStr(14, 5, "Set temp", FONT_arial_20X23, RGB_to_BRG(C_WHITE), RGB_to_BRG(C_BLACK));
		UG_DrawCircle(120, 40, 5, RGB_to_BRG(C_WHITE));
		UG_DrawCircle(120, 40, 4, RGB_to_BRG(C_WHITE));
		UG_DrawCircle(120, 40, 3, RGB_to_BRG(C_WHITE));
		LCD_PutStr(130, 30, "C", FONT_arial_36X44_C, RGB_to_BRG(C_WHITE), RGB_to_BRG(C_BLACK));


		LCD_PutStr(14, 95, "Actual temp", FONT_arial_20X23, RGB_to_BRG(C_WHITE), RGB_to_BRG(C_BLACK));
		UG_DrawCircle(120, 130, 5, RGB_to_BRG(C_WHITE));
		UG_DrawCircle(120, 130, 4, RGB_to_BRG(C_WHITE));
		UG_DrawCircle(120, 130, 3, RGB_to_BRG(C_WHITE));
		LCD_PutStr(130, 120, "C", FONT_arial_36X44_C, RGB_to_BRG(C_WHITE), RGB_to_BRG(C_BLACK));

		UG_DrawFrame(6, 89, 182,175, RGB_to_BRG(C_WHITE));
		UG_DrawFrame(5, 88, 183, 176, RGB_to_BRG(C_WHITE));

		LCD_PutStr(6, 180, "Handle type:", FONT_arial_16X18, RGB_to_BRG(C_WHITE), RGB_to_BRG(C_BLACK));
		LCD_PutStr(6, 195, "Input voltage:           V", FONT_arial_16X18, RGB_to_BRG(C_WHITE), RGB_to_BRG(C_BLACK));
		LCD_PutStr(6, 210, "MCU temp:              deg C", FONT_arial_16X18, RGB_to_BRG(C_WHITE), RGB_to_BRG(C_BLACK));

		/*
		UG_DrawLine(20, 0, 20, 220, RGB_to_BRG(C_DARK_SEA_GREEN));
		UG_DrawLine(21, 0, 21, 220, RGB_to_BRG(C_DARK_SEA_GREEN));

		LCD_PutStr(6, 271, "PRESETS", FONT_arial_20X23, RGB_to_BRG(C_DARK_SEA_GREEN), RGB_to_BRG(C_BLACK));
		memset(&buffer, '\0', sizeof(buffer));
		sprintf(buffer, "%.0f", flash_values.preset_temp_1);
		LCD_PutStr(130, 301, buffer, FONT_arial_20X23, RGB_to_BRG(C_DARK_SEA_GREEN), RGB_to_BRG(C_BLACK));
		memset(&buffer, '\0', sizeof(buffer));
		sprintf(buffer, "%.0f", flash_values.preset_temp_2);
		LCD_PutStr(190, 271, buffer, FONT_arial_20X23, RGB_to_BRG(C_DARK_SEA_GREEN), RGB_to_BRG(C_BLACK));
		 */
		UG_DrawFrame(288, 3, 312, 228, RGB_to_BRG(C_WHITE));
		UG_DrawFrame(289, 4, 311, 227, RGB_to_BRG(C_WHITE));

	}
}

void show_popup(char * text){
	UG_FillFrame(10, 50, 225, 105, RGB_to_BRG(C_ORANGE));
	UG_FillFrame(15, 55, 220, 100, RGB_to_BRG(C_WHITE));
	LCD_PutStr(20, 70, text, FONT_arial_20X23, RGB_to_BRG(C_ORANGE), RGB_to_BRG(C_WHITE));
	HAL_Delay(2000);
	LCD_draw_main_screen();
	standby_state_written_to_LCD = 0;
	sleep_state_written_to_LCD = 0;
}

void LCD_draw_earth_fault_popup(){
	heater_off();

	UG_FillFrame(10, 50, 205, 205, RGB_to_BRG(C_ORANGE));
	UG_FillFrame(15, 55, 200, 200, RGB_to_BRG(C_WHITE));
	LCD_PutStr(20, 60, "GROUNDING", FONT_arial_20X23, RGB_to_BRG(C_ORANGE), RGB_to_BRG(C_WHITE));
	LCD_PutStr(20, 80, "ERROR", FONT_arial_20X23, RGB_to_BRG(C_ORANGE), RGB_to_BRG(C_WHITE));

	LCD_PutStr(20, 120, "CHECK", FONT_arial_20X23, RGB_to_BRG(C_ORANGE), RGB_to_BRG(C_WHITE));
	LCD_PutStr(20, 140, "CONNECTIONS", FONT_arial_20X23, RGB_to_BRG(C_ORANGE), RGB_to_BRG(C_WHITE));
	LCD_PutStr(20, 160, "AND REBOOT", FONT_arial_20X23, RGB_to_BRG(C_ORANGE), RGB_to_BRG(C_WHITE));

	Error_Handler();
}

/* Get encoder value (Set temp.) and limit is NOT heating_halted*/
void get_set_temperature(){
	if(custom_temperature_on == 0){
		TIM2->CNT = clamp(TIM2->CNT, min_selectable_temperature, max_selectable_temperature);
		sensor_values.set_temperature = (uint16_t)(TIM2->CNT/2) * 2;
	}
}

/* Beep the beeper */
void beep(){
	if(flash_values.buzzer_enable == 1){
		HAL_TIM_PWM_Start_IT(&htim4, TIM_CHANNEL_2);
		HAL_TIM_Base_Start_IT(&htim17);
	}
}

/* Function to set state to EMERGENCY_SLEEP */
void handle_emergency_shutdown(){
	/* Get time when iron turns on */
	if(sensor_values.previous_state != RUN && active_state == RUN){
		previous_millis_left_stand = HAL_GetTick();
	}
	/* Set state to EMERGENCY_SLEEP if iron ON for longer time than emergency_time */
	if ((sensor_values.in_stand == 0) && (HAL_GetTick() - previous_millis_left_stand >= flash_values.emergency_time*60000) && active_state == RUN){
		show_popup("Standby timeout");
		change_state(EMERGENCY_SLEEP);
	}
	/* Set state to EMERGENCY_SLEEP if input voltage is too low */
	if((sensor_values.bus_voltage <= MIN_BUSVOLTAGE) && (active_state == RUN)){
		show_popup("Too Low voltage");
		change_state(EMERGENCY_SLEEP);
	}
	/* Set state to EMERGENCY_SLEEP if no tip detected (no current draw) */
	else if((sensor_values.heater_current < 1) && (active_state == RUN)){ //NT115 at 9V draws 81
		show_popup("NO tip detected");
		change_state(EMERGENCY_SLEEP);
	}
	/* Set state to EMERGENCY_SLEEP if iron is over max allowed temp */
	else if((sensor_values.thermocouple_temperature > EMERGENCY_SHUTDOWN_TEMPERATURE) && (active_state == RUN)){
		show_popup("OVERTEMP");
		change_state(EMERGENCY_SLEEP);
	}
}

/* Function to toggle between RUN and HALTED at each press of the encoder button */
void handle_button_status(){
	if(SW_1_pressed == 1){
		SW_1_pressed = 0;
		// toggle between RUN and HALTED
		if ((active_state == RUN) || (active_state == STANDBY)){
			change_state(HALTED);
		}
		else if ((active_state == HALTED) || (active_state == EMERGENCY_SLEEP)){
			change_state(RUN);
		}
		previous_millis_heating_halted_update = HAL_GetTick();

	}
	/* Set "set temp" to preset temp 1 */
	if(SW_2_pressed == 1){
		SW_2_pressed = 0;
		TIM2->CNT = flash_values.preset_temp_1;
	}
	/* Set "set temp" to preset temp 2 */
	if(SW_3_pressed == 1){
		SW_3_pressed = 0;
		TIM2->CNT = flash_values.preset_temp_2;
	}
}

/* Get the status of handle in/on stand to trigger SLEEP */
void get_stand_status(){
	uint8_t stand_status;
	if(HAL_GPIO_ReadPin (GPIOA, STAND_INP_Pin) == 0){
		stand_status = 1;
	}
	else{
		stand_status = 0;
	}
	sensor_values.in_stand = Moving_Average_Compute(stand_status, &stand_sense_filterStruct); /* Moving average filter */

	/* If handle is in stand set state to STANDBY */
	if(sensor_values.in_stand >= 0.2){
		if(active_state == RUN){
			change_state(STANDBY);
			previous_standby_millis = HAL_GetTick();
		}
		if((HAL_GetTick()-previous_standby_millis >= flash_values.standby_time*60000.0) && (active_state == STANDBY)){
			change_state(SLEEP);
		}
		if((active_state == EMERGENCY_SLEEP) || (active_state == HALTED)){
			change_state(SLEEP);
		}
	}

	/* If handle is NOT in stand and state is SLEEP, change state to RUN */
	if(sensor_values.in_stand < 0.2){
		if((active_state == SLEEP) || (active_state == STANDBY) || (active_state == RUN)){
			change_state(RUN);
		}
	}
}

/* Automatically detect handle type, T210 or T245 based on HANDLE_DETECTION_Pin, which is connected to BLUE for T210.*/
void get_handle_type(){
	uint8_t handle_status;
	if(HAL_GPIO_ReadPin (GPIOA, HANDLE_INP_1_Pin) == 0){
		handle_status = 0;
	}
	else{
		handle_status = 1;
	}
	sensor_values.handle1_sense = Moving_Average_Compute(handle_status, &handle1_sense_filterStruct); /* Moving average filter */

	if(HAL_GPIO_ReadPin (GPIOA, HANDLE_INP_2_Pin) == 0){
		handle_status = 0;
	}
	else{
		handle_status = 1;
	}
	sensor_values.handle2_sense = Moving_Average_Compute(handle_status, &handle2_sense_filterStruct); /* Moving average filter */

	/* Determine if NT115 handle is detected */
	if((sensor_values.handle1_sense >= 0.5) && (sensor_values.handle2_sense < 0.5)){
		handle = NT115;
		sensor_values.max_power_watt = 22; //22W
		Kp = 3;
		Ki = 1;
		Kd = 0.25;
		PID_MAX_I_LIMIT = 100;
	}
	/* Determine if T210 handle is detected */
	else if((sensor_values.handle1_sense < 0.5) && (sensor_values.handle2_sense >= 0.5)){
		handle = T210;
		sensor_values.max_power_watt = 65; //65W
		Kp = 5;
		Ki = 5.5;
		Kd = 0.25;
		PID_MAX_I_LIMIT = 125;
	}
	else{
		handle = T245;
		sensor_values.max_power_watt = 130; //130W
		Kp = 8;
		Ki = 5;
		Kd = 1;
		PID_MAX_I_LIMIT = 150;
	}

	/* If a custom power limit is specified in user flash, use this limit */
	if(flash_values.power_limit != 0){
		sensor_values.max_power_watt = flash_values.power_limit;
	}

	PID_SetTunings(&TPID, Kp, Ki, Kd); // Update PID parameters based on handle type
	PID_SetILimits(&TPID, -PID_MAX_I_LIMIT, PID_MAX_I_LIMIT); 	// Set max and min I limit
}

/* Interrupts at button press */
void HAL_GPIO_EXTI_Callback(uint16_t GPIO_Pin)
{
    if(((GPIO_Pin == SW_1_Pin) || (GPIO_Pin == SW_2_Pin) || (GPIO_Pin == SW_3_Pin)) && (SW_ready == 1)){ //A button is pressed
		HAL_TIM_Base_Start_IT(&htim16);
		SW_ready = 0;
    }
}

/* Interrupts at every encoder increment */
void HAL_TIM_IC_CaptureCallback(TIM_HandleTypeDef *htim){
	if ((htim->Channel == HAL_TIM_ACTIVE_CHANNEL_1) || (htim->Channel == HAL_TIM_ACTIVE_CHANNEL_2) ) {
		beep();
	}
}

// Callback:
void HAL_TIM_PWM_PulseFinishedCallback(TIM_HandleTypeDef *htim){
	if (((htim == &htim1) && (htim->Channel == HAL_TIM_ACTIVE_CHANNEL_1)) && (current_measurement_requested == 1)){
		current_measurement_requested = 0;
		current_measurement_done = 0;
		HAL_ADC_Start_IT(&hadc2);
	}
}

/* Timer Callbacks */
void HAL_TIM_PeriodElapsedCallback(TIM_HandleTypeDef *htim){
	/* take thermocouple measurement every 25 ms */
	if (htim == &htim6){
		thermocouple_measurement_done = 0;
		heater_off();
		__HAL_TIM_ENABLE(&htim7);
	}

	if (htim == &htim7){
		HAL_GPIO_WritePin(GPIOB, USR_2_Pin, GPIO_PIN_SET);
		HAL_ADC_Start_DMA(&hadc1, (uint32_t*)ADC1_BUF, (uint32_t)ADC1_BUF_LEN);	//Start ADC DMA mode
		}

	/* Beep length timer */
	if (htim == &htim17){
		HAL_TIM_Base_Stop_IT(&htim17);
		HAL_TIM_PWM_Stop_IT(&htim4, TIM_CHANNEL_2);
	}

	/* Button Debounce timer (50 ms) */
	if ((htim == &htim16 && SW_ready == 0)){
		if(HAL_GPIO_ReadPin(SW_1_GPIO_Port, SW_1_Pin) == GPIO_PIN_SET){
			SW_ready = 1;
			SW_1_pressed = 1;
			beep();
			HAL_TIM_Base_Stop_IT(&htim16);
		}
		else if(HAL_GPIO_ReadPin(SW_2_GPIO_Port, SW_2_Pin) == GPIO_PIN_SET){
			SW_ready = 1;
			SW_2_pressed = 1;
			beep();
			HAL_TIM_Base_Stop_IT(&htim16);
		}
		else if(HAL_GPIO_ReadPin(SW_3_GPIO_Port, SW_3_Pin) == GPIO_PIN_SET){
			SW_ready = 1;
			SW_3_pressed = 1;
			beep();
			HAL_TIM_Base_Stop_IT(&htim16);
		}
	}
}
/* ADC conversion completed Callbacks */
void HAL_ADC_ConvCpltCallback(ADC_HandleTypeDef* hadc){
	if ((hadc->Instance == ADC1) && (thermocouple_measurement_done == 0)){
		HAL_ADC_Stop_DMA(&hadc1);
		HAL_GPIO_WritePin(GPIOB, USR_2_Pin, GPIO_PIN_RESET);
		get_thermocouple_temperature();
		heater_on();
		/* Compute PID */
		PID_Compute(&TPID);
		thermocouple_measurement_done = 1;
	}
	if ((hadc->Instance == ADC2) && (current_measurement_done == 0)){
		sensor_values.leak_current = HAL_ADC_GetValue(&hadc2);
		current_raw = HAL_ADC_GetValue(&hadc2);
		heater_on();
		current_measurement_done = 1;
	}
}

/* ADC watchdog Callback */
void HAL_ADC_LevelOutOfWindowCallback(ADC_HandleTypeDef* hadc __unused){
		LCD_draw_earth_fault_popup();
}


// For DEBUG
//HAL_GPIO_WritePin(USR_1_GPIO_Port, USR_1_Pin, GPIO_PIN_SET);
//HAL_GPIO_WritePin(GPIOB, USR_2_Pin, GPIO_PIN_RESET);
//HAL_GPIO_WritePin(GPIOB, USR_3_Pin, GPIO_PIN_RESET);
//HAL_GPIO_WritePin(GPIOB, USR_4_Pin, GPIO_PIN_RESET);

/* USER CODE END 0 */

/**
  * @brief  The application entry point.
  * @retval int
  */
int main(void)
{
  /* MCU Configuration--------------------------------------------------------*/

  /* Reset of all peripherals, Initializes the Flash interface and the Systick. */
  HAL_Init();

  /* Configure the system clock */
  SystemClock_Config();

  /* Initialize all configured peripherals */
  MX_GPIO_Init();
  MX_DMA_Init();
  MX_ADC1_Init();
  MX_ADC2_Init();
  MX_CRC_Init();
  MX_TIM1_Init();
  MX_TIM2_Init();
  MX_TIM4_Init();
  MX_SPI2_Init();
  MX_I2C1_Init();
  MX_TIM17_Init();
  MX_USART1_UART_Init();
  MX_TIM7_Init();
  MX_TIM8_Init();
  MX_TIM6_Init();
  MX_TIM16_Init();
  /* USER CODE BEGIN 2 */

	set_heater_duty(0);		//Set heater duty to zero to ensure zero startup current
	HAL_TIMEx_PWMN_Start_IT(&htim1, TIM_CHANNEL_3);

	HAL_TIM_Encoder_Start_IT(&htim2, TIM_CHANNEL_ALL);
	HAL_TIM_PWM_Start_IT(&htim1, TIM_CHANNEL_1);
	__HAL_TIM_SET_COMPARE(&htim4, TIM_CHANNEL_2, 5); //Set BUZZER duty to 50%
	HAL_TIM_Base_Start_IT(&htim6);

	__HAL_TIM_ENABLE_IT(&htim7, TIM_IT_UPDATE);

	HAL_ADCEx_Calibration_Start(&hadc2, ADC_SINGLE_ENDED);

	HAL_ADCEx_Calibration_Start(&hadc1, ADC_SINGLE_ENDED);
	HAL_ADC_Start_DMA(&hadc1, (uint32_t*)ADC1_BUF, (uint32_t)ADC1_BUF_LEN);	//Start ADC DMA mode

	/* initialize moving average functions */
	Moving_Average_Init(&thermocouple_temperature_filter_struct,30);
	Moving_Average_Init(&thermocouple_temperature_display_filter_struct,10);
	Moving_Average_Init(&mcu_temperature_filter_struct,100);
	Moving_Average_Init(&input_voltage_filterStruct,25);
	Moving_Average_Init(&current_filterStruct,10);
	Moving_Average_Init(&stand_sense_filterStruct,20);
	Moving_Average_Init(&handle1_sense_filterStruct,20);
	Moving_Average_Init(&handle2_sense_filterStruct,20);

  /* USER CODE END 2 */

  /* Infinite loop */
  /* USER CODE BEGIN WHILE */
	HAL_Delay(200);

  		// Check if user data in flash is valid, if not - write default parameters
  		if(!FlashCheckCRC()){
  	    	FlashWrite(&default_flash_values);
  		}

  		/* Read flash data */
  	    FlashRead(&flash_values);

  	    /* Set screen rotation */
  	    if((flash_values.screen_rotation == 0) || (flash_values.screen_rotation == 2)){
		  #define LCD_WIDTH  240
		  #define LCD_HEIGHT 320
  	    }
  	    if((flash_values.screen_rotation == 1) || (flash_values.screen_rotation == 3)){
		  #define LCD_WIDTH  240
		  #define LCD_HEIGHT 320
		}

  	    LCD_init();
  	  	LCD_SetRotation(flash_values.screen_rotation);

  		/* Set startup state */
  	    change_state(HALTED);

  		settings_menue();

  		/* Set initial encoder timer value */
  		TIM2->CNT = flash_values.startup_temperature;

  		/* Initiate PID controller */
  		PID(&TPID, &sensor_values.thermocouple_temperature, &PID_output, &PID_setpoint, Kp, Ki, Kd, _PID_CD_DIRECT);
  		PID_SetMode(&TPID, _PID_MODE_AUTOMATIC);
  		PID_SetSampleTime(&TPID, interval_PID_update, 0); 		//Set PID sample time to "interval_PID_update" to make sure PID is calculated every time it is called
  		PID_SetOutputLimits(&TPID, 0, PID_MAX_OUTPUT); 			// Set max and min output limit
        PID_SetILimits(&TPID, -PID_MAX_I_LIMIT, PID_MAX_I_LIMIT);         // Set max and min I limit


  		/* Draw the main screen decoration */
  		LCD_draw_main_screen();

  		/* Init and fill filter structures with initial values */
  		for (int i = 0; i<200;i++){
  			get_bus_voltage();
  			get_heater_current();
  			get_mcu_temp();
  			get_thermocouple_temperature();
  			get_handle_type();
  			get_stand_status();
  			handle_button_status();
  		}

  		/* Start-up beep */
  		beep();
  		HAL_Delay(100);
  		beep();


  		while (1){
  			if(HAL_GetTick() - previous_sensor_update_high_update >= interval_sensor_update_high_update){
  				get_stand_status();
  				get_handle_type();
  				get_set_temperature();
  				handle_button_status();
  	  			handle_emergency_shutdown();
  				previous_sensor_update_high_update = HAL_GetTick();
  			}

  			if(HAL_GetTick() - previous_sensor_update_low_update >= interval_sensor_update_low_update){
  				get_bus_voltage();
  				get_heater_current();
  				get_mcu_temp();
  				previous_sensor_update_low_update = HAL_GetTick();
  			}

  			/* switch */
  			switch (active_state) {
  				case RUN: {
  					PID_setpoint = sensor_values.set_temperature;
  					break;
  				}
  				case STANDBY: {
  				  if(flash_values.standby_temp > sensor_values.set_temperature){
  				    PID_setpoint = sensor_values.set_temperature;
  				  }
  				  else{
  				    PID_setpoint = flash_values.standby_temp;
  				  }
  				  break;
  				}
  				case SLEEP:
  				case EMERGENCY_SLEEP:
  				case HALTED: {
  					PID_setpoint = 0;
  					break;
  				}
  			}

  			// TUNING - ONLY USED DURING MANUAL PID TUNING
  			// ----------------------------------------------
  			//custom_temperature_on = 1;
  			//PID_SetTunings(&TPID, Kp_tuning, Ki_tuning, Kd_tuning/10.0);
  			//PID_SetILimits(&TPID, -PID_MAX_I_LIMIT_tuning, PID_MAX_I_LIMIT_tuning); 	// Set max and min I limit
  			//sensor_values.set_temperature = temperature_tuning;
  			// ----------------------------------------------

  			/* Send debug information */
  			if(HAL_GetTick() - previous_millis_debug >= interval_debug){
  				memset(&buffer, '\0', sizeof(buffer));
  				sprintf(buffer, "%3.1f\t%3.1f\t%3.1f\t%3.1f\t%3.1f\t%3.1f\t%3.1f\n",
  						sensor_values.thermocouple_temperature, PID_setpoint,
						PID_output/PID_MAX_OUTPUT*100.0, PID_GetPpart(&TPID)/10.0, PID_GetIpart(&TPID)/10.0, PID_GetDpart(&TPID)/10.0, sensor_values.heater_current);
  				//CDC_Transmit_FS((uint8_t *) buffer, strlen(buffer)); //Print string over USB virtual COM port
  			    HAL_UART_Transmit_IT(&huart1, (uint8_t *) buffer, strlen(buffer));
  				previous_millis_debug = HAL_GetTick();
  			}

 			/* Detect if a tip is present by sending a short voltage pulse and sense current */
			if (flash_values.current_measurement == 1){
  				if(HAL_GetTick() - previous_measure_current_update >= interval_measure_current){
  					if(thermocouple_measurement_done == 1){ //Only take current measurement if thermocouple measurement is not ongoing
						current_measurement_done = 0;
						set_heater_duty(PID_MAX_OUTPUT/2);
						current_measurement_requested = 1;
	  					previous_measure_current_update = HAL_GetTick();
  					}
  				}
			}
			else{
				sensor_values.heater_current = 1; // If the current is not measured, apply a dummy value to heater_current
			}

  			/* Update display */
  			if(HAL_GetTick() - previous_millis_display >= interval_display){
  				update_display();
  				previous_millis_display = HAL_GetTick();
  			}
    /* USER CODE END WHILE */

    /* USER CODE BEGIN 3 */
  }
  /* USER CODE END 3 */
}

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
