squidgeefish/AxxSolder/(commit log)

2024-05-25 Add GMT020-02 model
    [GMT020-02 Ver1.1 LCD.step]
2024-05-25 Create Lite version of board
    Mark all USB-C components as DNP (except I2C pullups)
    Swap LCD footprint from Adafruit 4311 to commodity GMT020-02 LCD
    [AxxSolder.kicad_pcb, AxxSolder.kicad_sch]
2024-05-25 Finish Lite modifications
    Fix upper mounting holes (no longer align with display; now aligned to PCB)
    Add GitHub link for licensing purposes (I think this is necesssary for GPL)
    [AxxSolder-B_Cu.gbr, AxxSolder-B_Mask.gbr, AxxSolder-B_Paste.gbr, AxxSolder-B_Silkscreen.gbr, AxxSolder-Edge_Cuts.gbr, AxxSolder-F_Cu.gbr, AxxSolder-F_Mask.gbr, AxxSolder-F_Paste.gbr]
